cenders77/TrimatikLogger/example.h

#ifndef TRIMATIK_DATA_H
#define TRIMATIK_DATA_H

const unsigned char exampleLog[52832] = {
	0xE2, 0xC7, 0x6B, 0x69, 0x5B, 0x72, 0x09, 0x00, 0x00, 0x00, 0x31, 0xFF, 0x00, 0x00, 0x3A, 0x69, 
	0x00, 0x00, 0x35, 0x3C, 0x00, 0x00, 0x25, 0xD1, 0x00, 0x00, 0x45, 0x11, 0x00, 0x00, 0x2F, 0x05, 
	0x00, 0x00, 0x7F, 0x84, 0x05, 0x00, 0x3A, 0x6A, 0x04, 0x00, 0x3A, 0x6B, 0x01, 0x00, 0x01, 0x01, 
	0x04, 0x00, 0x3A, 0x6C, 0x05, 0x00, 0x3A, 0x6D, 0x03, 0x00, 0x01, 0x01, 0x02, 0x00, 0x3A, 0x6E, 
	0x03, 0x00, 0x3A, 0x6F, 0x05, 0x00, 0x3A, 0x70, 0x02, 0x00, 0x01, 0x01, 0x02, 0x00, 0x3A, 0x71, 
	0x07, 0x00, 0x3A, 0x72, 0x03, 0x00, 0x3A, 0x73, 0x01, 0x00, 0x01, 0x01, 0x04, 0x00, 0x3A, 0x74, 
	0x03, 0x00, 0x3A, 0x75, 0x02, 0x00, 0x25, 0xD0, 0x02, 0x00, 0x3A, 0x76, 0x06, 0x00, 0x3A, 0x77, 
	0x06, 0x00, 0x3A, 0x78, 0x03, 0x00, 0x3A, 0x79, 0x05, 0x00, 0x3A, 0x7A, 0x05, 0x00, 0x3A, 0x7B, 
	0x07, 0x00, 0x3A, 0x7C, 0x05, 0x00, 0x3A, 0x7D, 0x05, 0x00, 0x3A, 0x7E, 0x05, 0x00, 0x3A, 0x7F, 
	0x09, 0x00, 0x3A, 0x80, 0x06, 0x00, 0x3A, 0x81, 0x0C, 0x00, 0x3A, 0x82, 0x1D, 0x00, 0x3A, 0x81, 
	0x0A, 0x00, 0x3A, 0x80, 0x09, 0x00, 0x3A, 0x7F, 0x08, 0x00, 0x3A, 0x7E, 0x05, 0x00, 0x3A, 0x7D, 
	0x05, 0x00, 0x3A, 0x7C, 0x09, 0x00, 0x3A, 0x7B, 0x03, 0x00, 0x3A, 0x7A, 0x07, 0x00, 0x3A, 0x79, 
	0x07, 0x00, 0x3A, 0x78, 0x0A, 0x00, 0x3A, 0x77, 0x08, 0x00, 0x3A, 0x76, 0x09, 0x00, 0x3A, 0x75, 
	0x0F, 0x00, 0x3A, 0x74, 0x11, 0x00, 0x3A, 0x73, 0x14, 0x00, 0x3A, 0x72, 0x16, 0x00, 0x3A, 0x71, 
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
	0x2A, 0x00, 0x3A, 0x68, 0x29, 0x00, 0x3A, 0x67, 0x34, 0x00, 0x3A, 0x66, 0x1D, 0x00, 0x3A, 0x65, 
	0x1B, 0x00, 0x3A, 0x64, 0x25, 0x00, 0x3A, 0x63, 0x2E, 0x00, 0x3A, 0x62, 0x33, 0x00, 0x3A, 0x61, 
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
};

#endif
